sofwerx/polytope_node/GPS Shield/GPS Shield.jpg

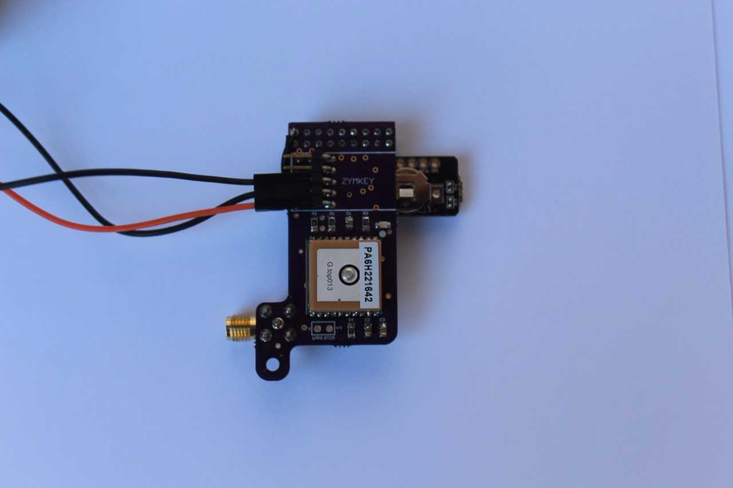
GPS Shield/GPS Shield.jpg
