sofwerx/polytope_node/GPS Shield/GPS Shield_Zymbit.jpg

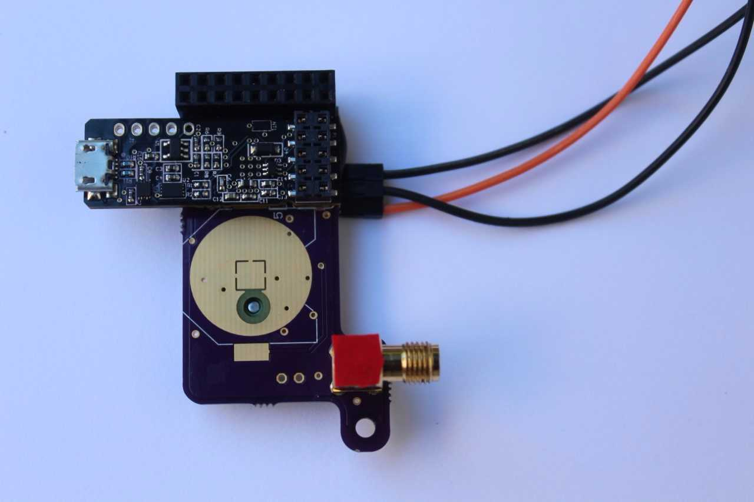
GPS Shield/GPS Shield_Zymbit.jpg
