sofwerx/polytope_node/README.md

# polytope_node
Compute/Sensor node for Polytope
