sofwerx/polytope_node/GPS Shield/GPS_Shield_BoardLayout.jpg

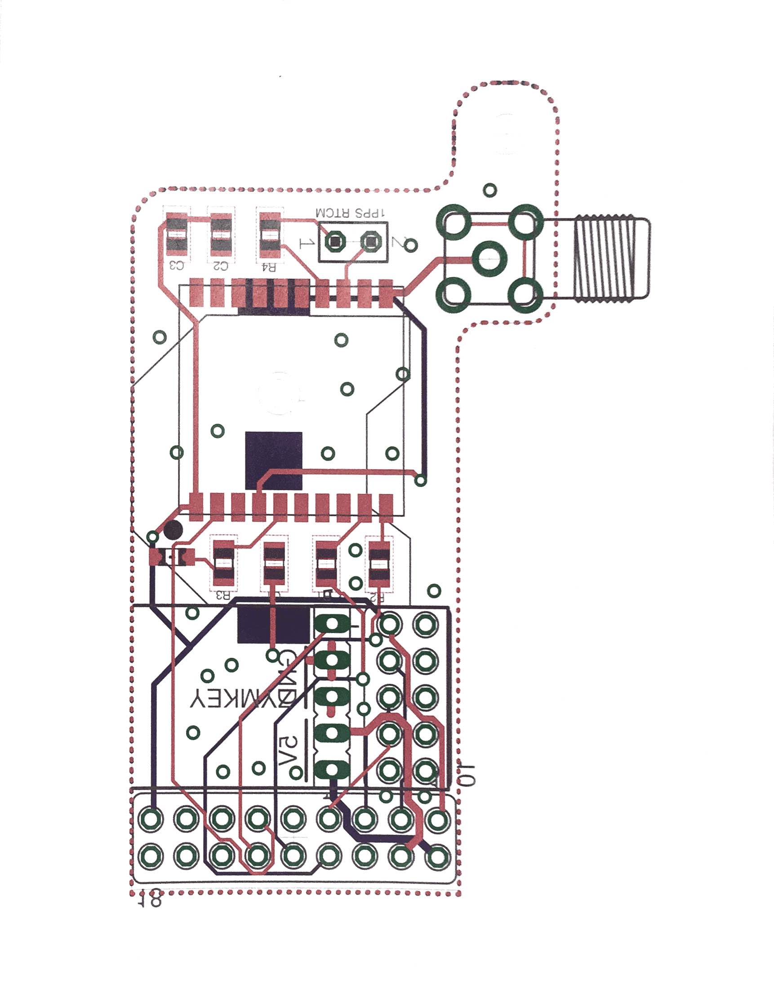
GPS Shield/GPS_Shield_BoardLayout.jpg
