sofwerx/polytope_node/GPS Shield/GPS_Shield_Schematic.jpg

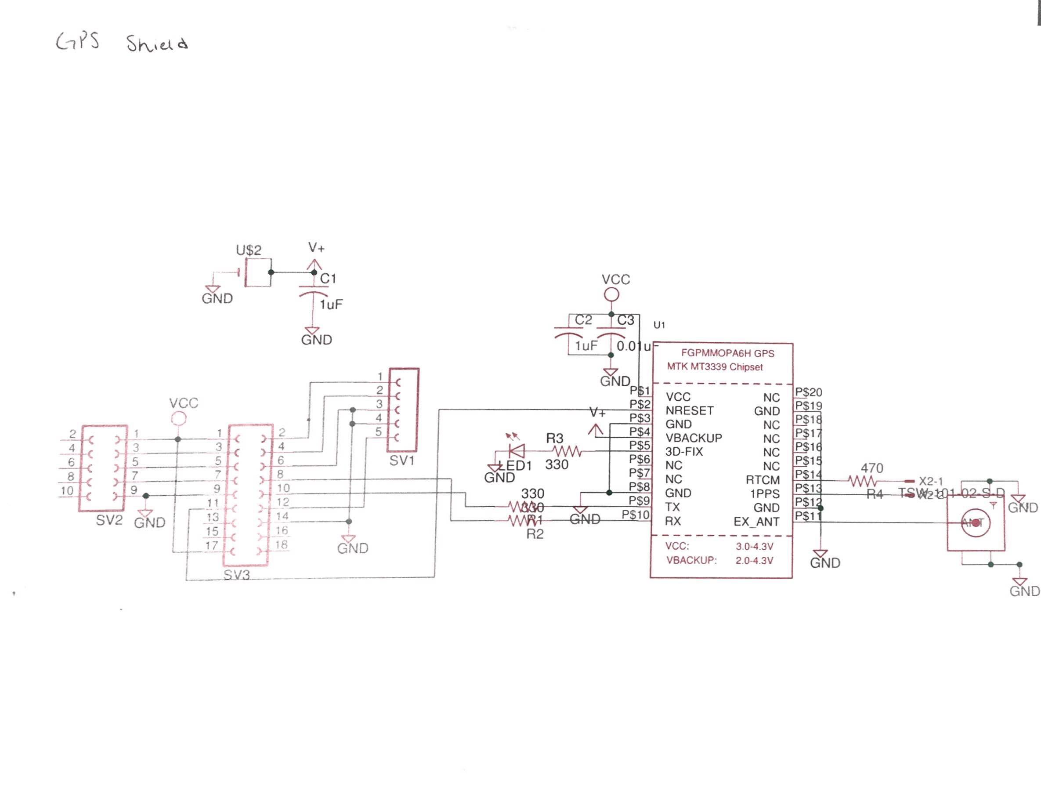
GPS Shield/GPS_Shield_Schematic.jpg
