sofwerx/polytope_node/Power Board/SDR-RPI 3.0/Power Board.jpg

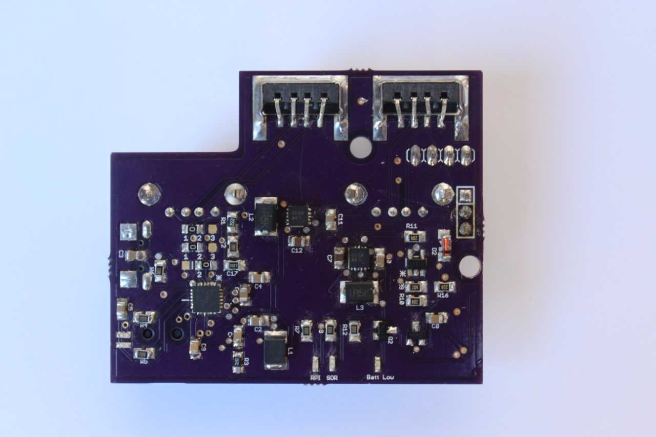
Power Board/SDR-RPI 3.0/Power Board.jpg
