sofwerx/polytope_node/GPS Shield/GPS_Shield_BOM.jpg

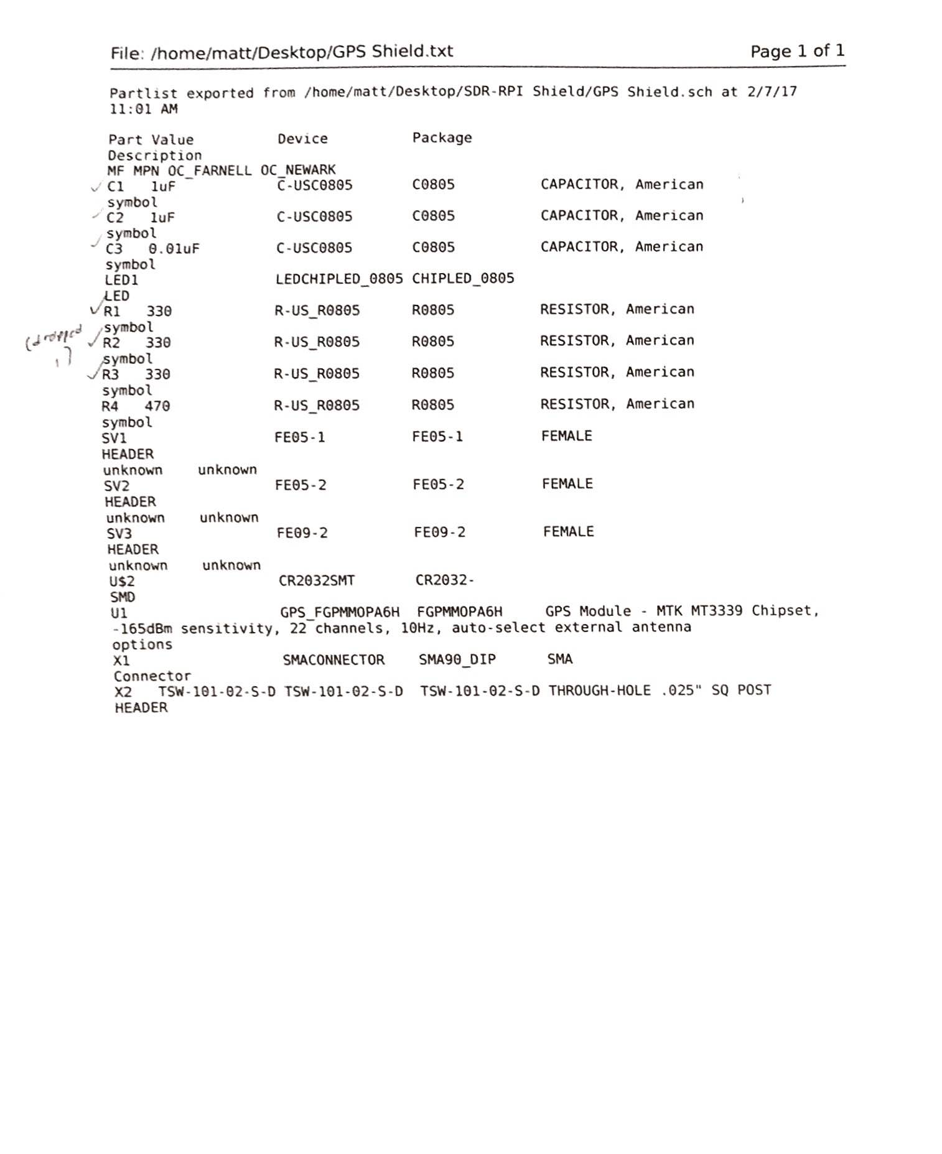
GPS Shield/GPS_Shield_BOM.jpg
