sofwerx/polytope_node/RFnode Enclosure/stl/SWXpiSDR2_body1.stl

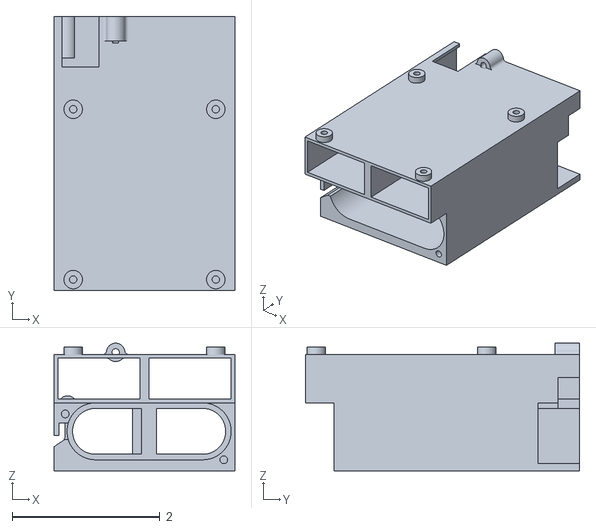
[picture p7: CAD file, 2017-07-17]
RFnode Enclosure/stl/SWXpiSDR2_body1.stl
2.44 x 3.71 x 1.73
