sofwerx/polytope_node/RFnode Enclosure/stl/SWXpiSDR2_body1_boardcap.stl

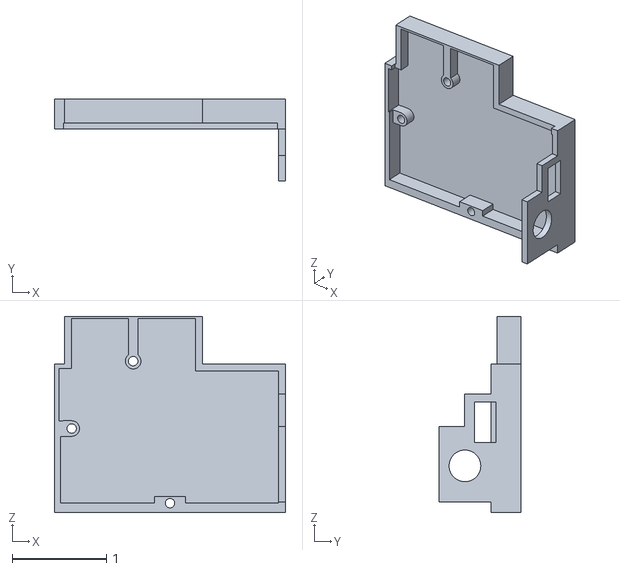
[picture p8: CAD file, 2017-07-17]
RFnode Enclosure/stl/SWXpiSDR2_body1_boardcap.stl
2.44 x 0.867 x 2.08
