sofwerx/polytope_node/RFnode Enclosure/stl/SWXpiSDR2_body1_top.stl

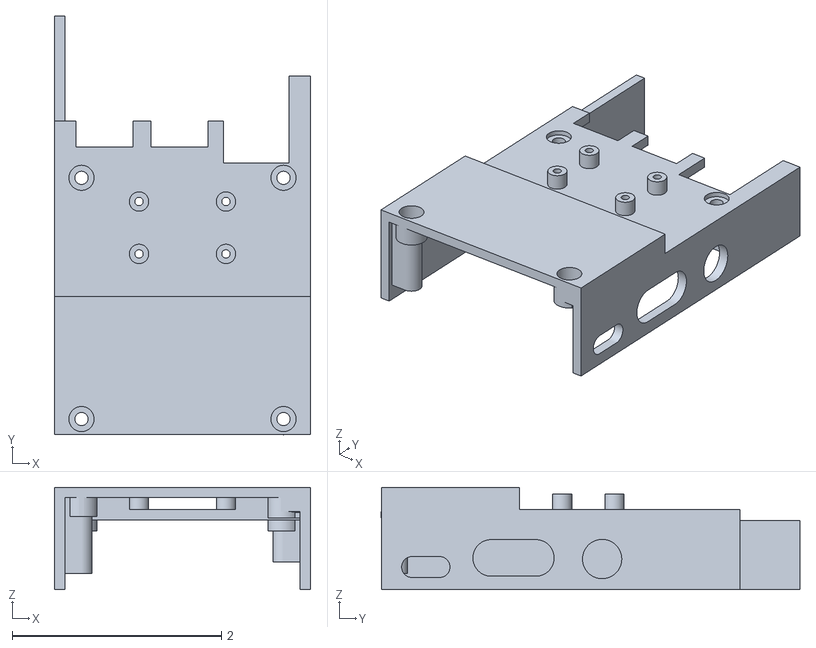
[picture p9: CAD file, 2017-07-17]
RFnode Enclosure/stl/SWXpiSDR2_body1_top.stl
2.44 x 4.00 x 0.979
