sofwerx/polytope_node/RFnode Enclosure/stl/SWXpiSDR2_body1_cap.stl

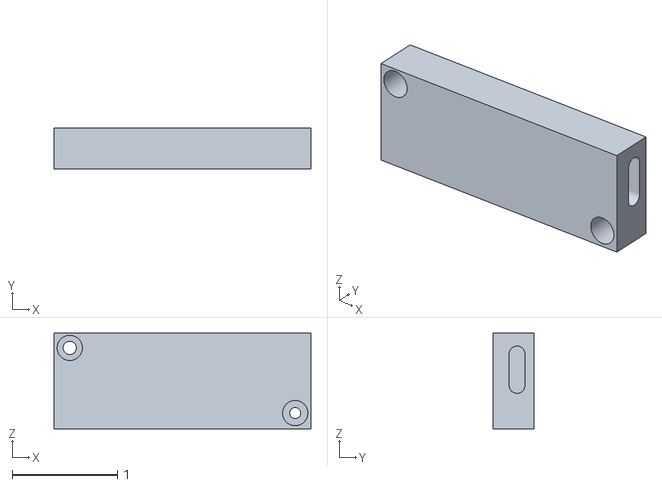
[picture p10: CAD file, 2017-07-17]
RFnode Enclosure/stl/SWXpiSDR2_body1_cap.stl
2.44 x 0.387 x 0.91
