sofwerx/polytope_node/(list of files, cad)

Other CAD files:
Fan Control/Microfan Controller.X/dist/default/production/Microfan_Controller.X.production.obj
