sofwerx/polytope_node/Fan Control/Microfan Controller.brd

## EAGLE design Fan Control/Microfan Controller.brd (2017-07-18)

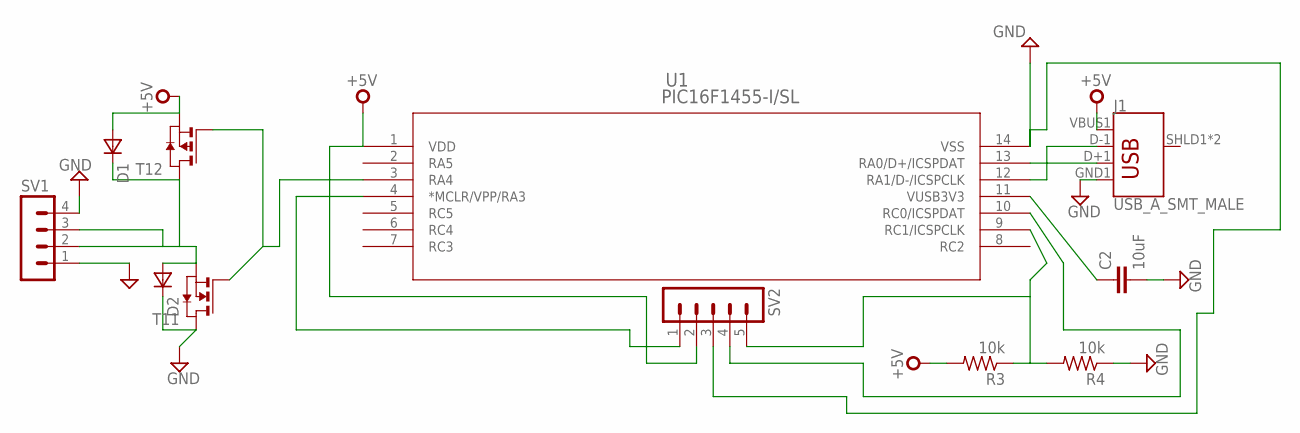
[picture p11: schematic Microfan Controller.sch]

Parts:
C2: 10uF; C0805
D1, D2: VAR2SOT23; SOT-23
J1: USB_A_SMT_MALE; USB-A-SMT-MALE
R3, R4: 10k; R0805
SV1: MA04-1
SV2: MA05-1
T1: PN_MOSFET-MSOP8; MSOP8
U1: PIC16F1455-I/SL; SOIC14_SL

Connections:
+5V: D1.3 (A), J1.VBUS1 (VBUS), R3.2, SV2.2, T1.3 (S), U1.1 (VDD)
GND: C2.2, D2.1 (C), J1.GND1 (GND), R4.1, SV1.1, SV1.4, T1.7 (D), T1.8 (D)
unnamed: SV2.1, U1.4 (*MCLR/VPP/RA3)
unnamed: J1.D-1 (D-), U1.12 (RA1/D-/ICSPCLK)
unnamed: T1.2 (G), T1.4 (G), U1.3 (RA4)
unnamed: R3.1, R4.2, SV2.5, U1.9 (RC1/ICSPCLK)
unnamed: D1.1 (C), D2.3 (A), SV1.2, SV1.3, T1.1 (S), T1.5 (D), T1.6 (D)
unnamed: J1.D+1 (D+), U1.13 (RA0/D+/ICSPDAT)
unnamed: SV2.3, U1.14 (VSS)
unnamed: SV2.4, U1.10 (RC0/ICSPDAT)
VUSB3V3: U1.11 (VUSB3V3)

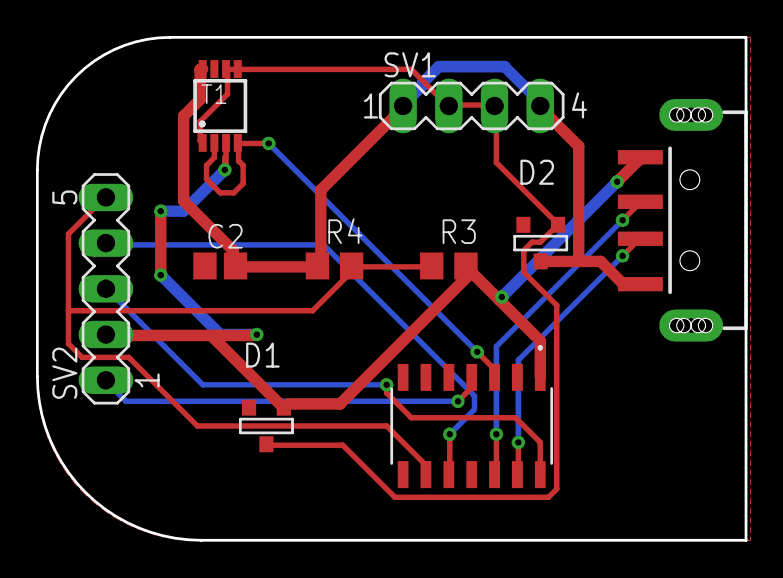
[picture p12: board Microfan Controller.brd from above]

Board: 2 copper layers, 39.4 x 27.9 mm, 10 parts (0 on the bottom side), 10 nets.
