sofwerx/polytope_node/Power Board/SDR-RPI 3.0/SDR-RPI Shield 3.0.brd

## EAGLE design Power Board/SDR-RPI 3.0/SDR-RPI Shield 3.0.brd (2017-07-06)

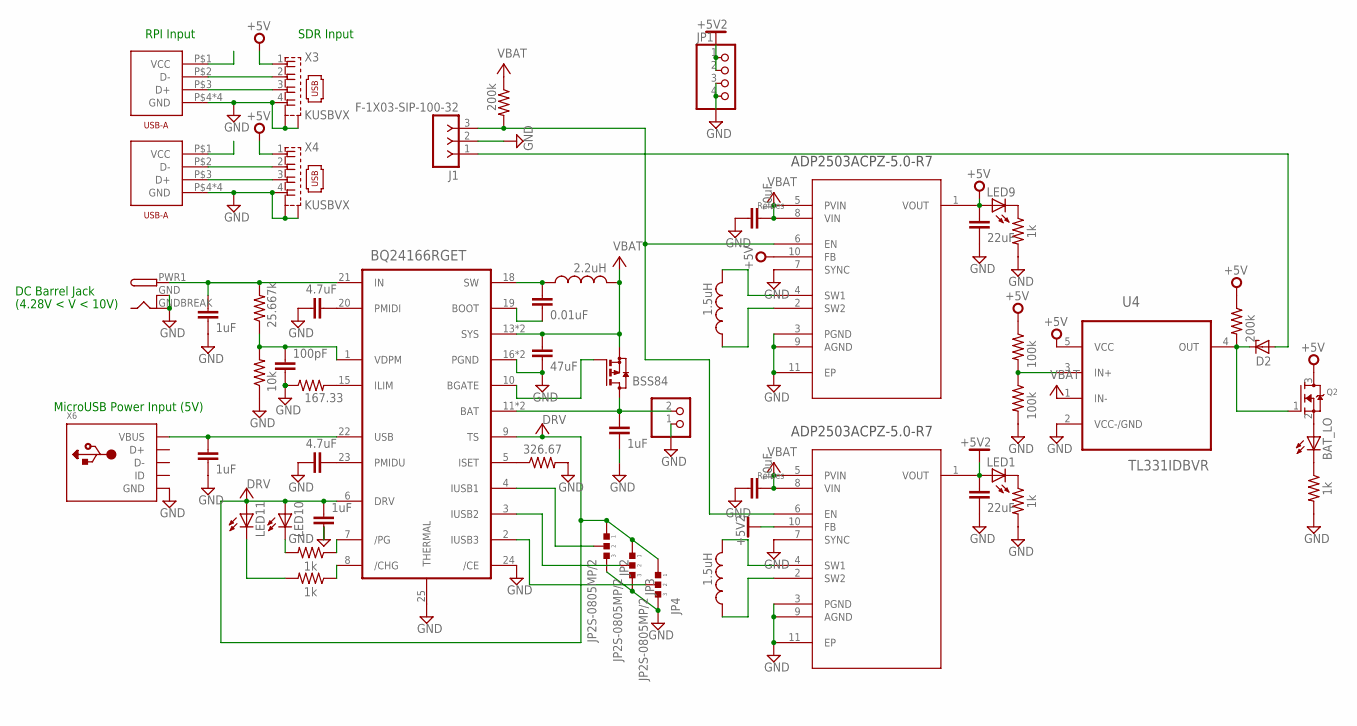
[picture p13: schematic SDR-RPI Shield 3.0.sch]

Parts:
BAT_LO: LED_ESML0603; LED_SML0603
C1, C3, C5, C8: 1uF; C0805
C2, C4: 4.7uF; C0805
C6: 0.01uF; C0805
C7, C12: 22uF; C0805
C9: 47uF; C0805
C10, C11: 10uF; C0805
C17: 100pF; C0805
CN1: JST_2PIN-SMT; JST-PH-2-SMT
CN3: DCBARRELSMT; DCJACK_2MM_SMT
D2: ZENER-DIODESOD80C; SOD80C
J1: F-1X03-SIP-100-32; SIP-100-03-32
JP1: PINHD-1X4; 1X04
JP2, JP3, JP4: JP2S-0805MP/2; R0805MP/2
L1: 2.2uH; L1812
L2, L3: 1.5uH; L1812
LED1, LED9, LED10, LED11: LED_ESML0603; LED_SML0603
Q1: BSS84; SOT23
Q2: MOSFET-NREFLOW; SOT23
R1: 25.667k; M0805
R2: 10k; M0805
R3: 167.33; M0805
R4, R5, R7, R8, R12: 1k; M0805
R6: 326.67; M0805
R9, R10: 100k; M0805
R11, R16: 200k; M0805
U1: BQ24166RGET; QFN50P400X400X100-25N
U2, U3: ADP2503ACPZ-5.0-R7; DFN300X300X80-11N
U4: TL331IDBVR; SOT95P280X145-5N
U$1, U$2: USB-A
X3, X4: KUSBVX
X6: USB_MICRO_20329_V2; 4UCONN_20329_V2

Connections:
+5V: C12.1, LED9.A, Q2.3 (D), R9.1, R11.1, U3.1 (VOUT), U3.10 (FB), U4.5 (VCC), X3.1, X4.1
+5V2: C7.1, JP1.1, JP1.2, LED1.A, U2.1 (VOUT), U2.10 (FB)
DRV: C5.1, JP2.1, JP3.1, JP4.1, LED10.A, LED11.A, U1.6 (DRV), U1.9 (TS)
GND: C1.2, C2.2, C3.2, C4.2, C5.2, C7.2, C8.2, C9.2, C10.1, C11.1, C12.2, C17.2, CN1.1 (2), CN3.GND (GNDBREAK), CN3.GNDBREAK (GND), J1.2, JP1.3, JP1.4, JP2.3, JP3.3, JP4.3, R2.1, R3.1, R6.2, R7.2, R8.2, R10.2, R12.2, U1.16 (PGND), U1.17 (PGND), U1.24 (/CE), U1.25 (THERMAL), U2.3 (PGND), U2.7 (SYNC), U2.9 (AGND), U2.11 (EP), U3.3 (PGND), U3.7 (SYNC), U3.9 (AGND), U3.11 (EP), U4.2 (VCC-/GND), U$1.P$4 (GND), U$1.P$5 (GND), U$1.P$6 (GND), U$1.P$8 (GND), U$2.P$4 (GND), U$2.P$5 (GND), U$2.P$6 (GND), U$2.P$8 (GND), X3.4, X3.M1 (S1), X3.M2 (S2), X4.4, X4.M1 (S1), X4.M2 (S2), X6.BASE@1 (GND), X6.BASE@2 (GND), X6.GND, X6.SPRT@1 (GND), X6.SPRT@2 (GND), X6.SPRT@3 (GND), X6.SPRT@4 (GND)
unnamed: C17.1, R1.1, R2.2, U1.1 (VDPM)
unnamed: R4.1, U1.7 (/PG)
unnamed: R5.1, U1.8 (/CHG)
unnamed: C1.1, CN3.PWR1 (PWR), R1.2, U1.21 (IN)
unnamed: C2.1, U1.20 (PMIDI)
unnamed: R3.2, U1.15 (ILIM)
unnamed: C3.1, U1.22 (USB), X6.VBUS
unnamed: C4.1, U1.23 (PMIDU)
unnamed: Q1.1 (G), U1.10 (BGATE)
unnamed: LED10.C, R4.2
unnamed: C6.2, U1.19 (BOOT)
unnamed: LED11.C, R5.2
unnamed: C6.1, L1.1, U1.18 (SW)
unnamed: J1.3, R16.2, U2.6 (EN), U3.6 (EN)
unnamed: L2.2, U3.4 (SW1)
unnamed: L2.1, U3.2 (SW2)
unnamed: C8.1, CN1.2 (1), Q1.3 (D), U1.11 (BAT), U1.12 (BAT)
unnamed: R6.1, U1.5 (ISET)
unnamed: R9.2, R10.1, U4.3 (IN+)
unnamed: LED1.C, R7.1
unnamed: L3.2, U2.4 (SW1)
unnamed: LED9.C, R8.1
unnamed: D2.A, J1.1
unnamed: L3.1, U2.2 (SW2)
unnamed: BAT_LO.A, Q2.2 (S)
unnamed: D2.C, Q2.1 (G), R11.2, U4.4 (OUT)
unnamed: BAT_LO.C, R12.1
unnamed: U$1.P$2 (D-), X3.2
unnamed: U$1.P$3 (D+), X3.3
unnamed: U$2.P$2 (D-), X4.2
unnamed: U$2.P$3 (D+), X4.3
unnamed: JP2.2, U1.4 (IUSB1)
unnamed: JP3.2, U1.3 (IUSB2)
unnamed: JP4.2, U1.2 (IUSB3)
V+: C9.1, C10.2, C11.2, L1.2, Q1.2 (S), R16.1, U1.13 (SYS), U1.14 (SYS), U2.5 (PVIN), U2.8 (VIN), U3.5 (PVIN), U3.8 (VIN), U4.1 (IN-)

Notes on the sheet:
RPI Input
SDR Input
MicroUSB Power Input (5V)
DC Barrel Jack
(4.28V < V < 10V)

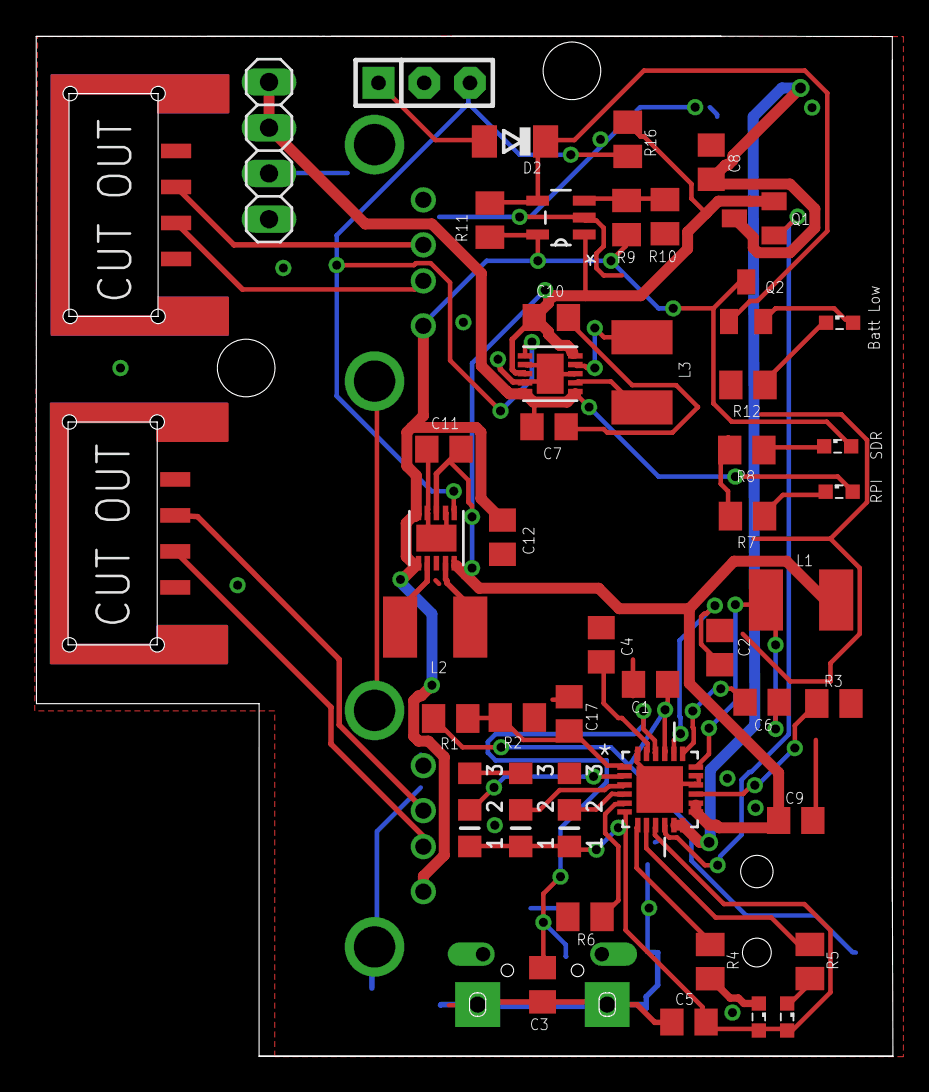
[picture p14: board SDR-RPI Shield 3.0.brd from above]

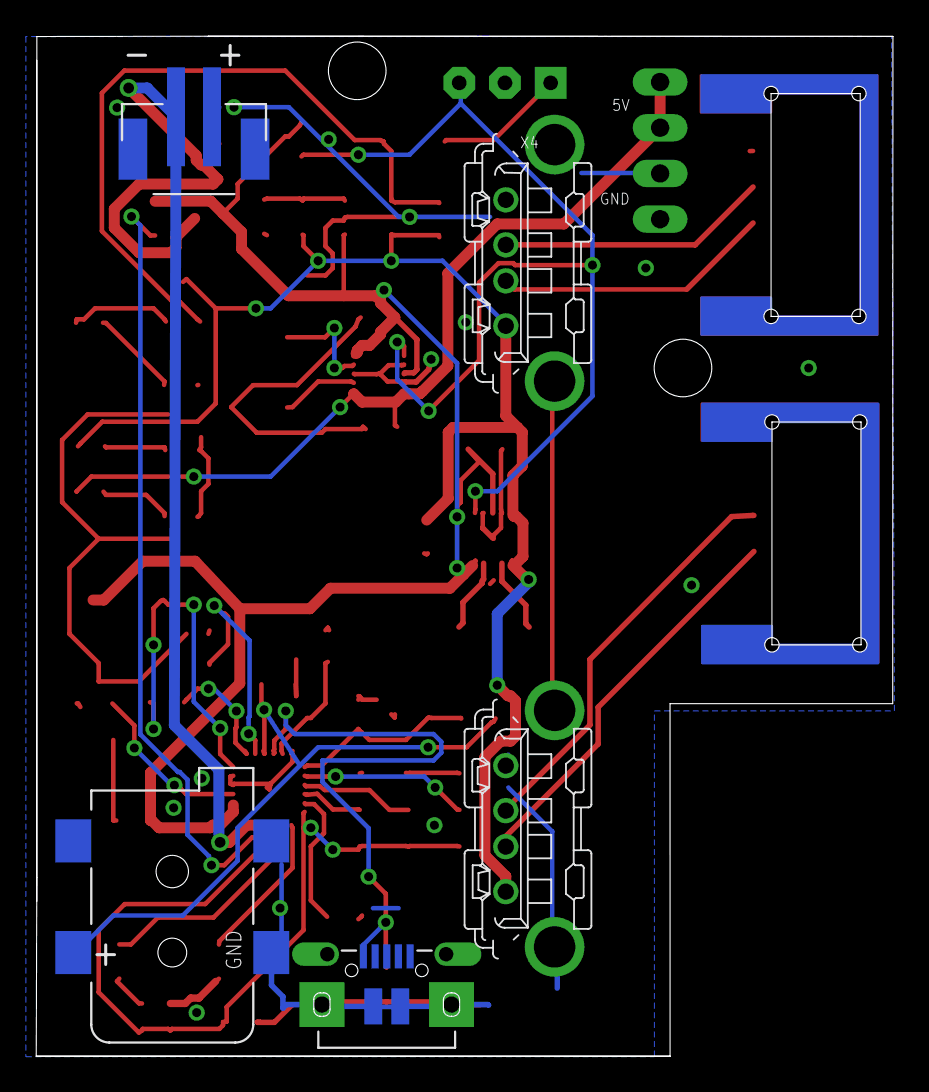
[picture p15: board SDR-RPI Shield 3.0.brd from below]

Board: 2 copper layers, 47.6 x 56.7 mm, 53 parts (5 on the bottom side), 39 nets.
