sofwerx/polytope_node/Fan Control/Microfan Controller.X/mcc_generated_files/pin_manager.h

#ifndef PIN_MANAGER_H
#define PIN_MANAGER_H

#define INPUT   1
#define OUTPUT  0

#define HIGH    1
#define LOW     0

#define ANALOG      1
#define DIGITAL     0

#define PULL_UP_ENABLED      1
#define PULL_UP_DISABLED     0

#define IO_RA0_PORT               PORTAbits.RA0
#define IO_RA0_GetValue()           PORTAbits.RA0

#define IO_RA1_PORT               PORTAbits.RA1
#define IO_RA1_GetValue()           PORTAbits.RA1

#define IO_RA4_TRIS               TRISAbits.TRISA4
#define IO_RA4_LAT                LATAbits.LATA4
#define IO_RA4_PORT               PORTAbits.RA4
#define IO_RA4_WPU                WPUAbits.WPUA4
#define IO_RA4_ANS                ANSELAbits.ANSA4
#define IO_RA4_SetHigh()            do { LATAbits.LATA4 = 1; } while(0)
#define IO_RA4_SetLow()             do { LATAbits.LATA4 = 0; } while(0)
#define IO_RA4_Toggle()             do { LATAbits.LATA4 = ~LATAbits.LATA4; } while(0)
#define IO_RA4_GetValue()           PORTAbits.RA4
#define IO_RA4_SetDigitalInput()    do { TRISAbits.TRISA4 = 1; } while(0)
#define IO_RA4_SetDigitalOutput()   do { TRISAbits.TRISA4 = 0; } while(0)
#define IO_RA4_SetPullup()      do { WPUAbits.WPUA4 = 1; } while(0)
#define IO_RA4_ResetPullup()    do { WPUAbits.WPUA4 = 0; } while(0)
#define IO_RA4_SetAnalogMode()  do { ANSELAbits.ANSA4 = 1; } while(0)
#define IO_RA4_SetDigitalMode() do { ANSELAbits.ANSA4 = 0; } while(0)

#define IO_RC0_TRIS               TRISCbits.TRISC0
#define IO_RC0_LAT                LATCbits.LATC0
#define IO_RC0_PORT               PORTCbits.RC0
#define IO_RC0_ANS                ANSELCbits.ANSC0
#define IO_RC0_SetHigh()            do { LATCbits.LATC0 = 1; } while(0)
#define IO_RC0_SetLow()             do { LATCbits.LATC0 = 0; } while(0)
#define IO_RC0_Toggle()             do { LATCbits.LATC0 = ~LATCbits.LATC0; } while(0)
#define IO_RC0_GetValue()           PORTCbits.RC0
#define IO_RC0_SetDigitalInput()    do { TRISCbits.TRISC0 = 1; } while(0)
#define IO_RC0_SetDigitalOutput()   do { TRISCbits.TRISC0 = 0; } while(0)
#define IO_RC0_SetAnalogMode()  do { ANSELCbits.ANSC0 = 1; } while(0)
#define IO_RC0_SetDigitalMode() do { ANSELCbits.ANSC0 = 0; } while(0)

#define IO_RC1_TRIS               TRISCbits.TRISC1
#define IO_RC1_LAT                LATCbits.LATC1
#define IO_RC1_PORT               PORTCbits.RC1
#define IO_RC1_ANS                ANSELCbits.ANSC1
#define IO_RC1_SetHigh()            do { LATCbits.LATC1 = 1; } while(0)
#define IO_RC1_SetLow()             do { LATCbits.LATC1 = 0; } while(0)
#define IO_RC1_Toggle()             do { LATCbits.LATC1 = ~LATCbits.LATC1; } while(0)
#define IO_RC1_GetValue()           PORTCbits.RC1
#define IO_RC1_SetDigitalInput()    do { TRISCbits.TRISC1 = 1; } while(0)
#define IO_RC1_SetDigitalOutput()   do { TRISCbits.TRISC1 = 0; } while(0)
#define IO_RC1_SetAnalogMode()  do { ANSELCbits.ANSC1 = 1; } while(0)
#define IO_RC1_SetDigitalMode() do { ANSELCbits.ANSC1 = 0; } while(0)

void PIN_MANAGER_Initialize (void);
void PIN_MANAGER_IOC(void);



#endif
