sofwerx/polytope_node/(notices)

Notices in the files:
parts and their libraries:
con-headers-jp: Copyright (C) 2008, Bob Starr
jumpers: Copyright (C) 2009, Bob Starr
supply0: Copyright (C) 2007, Bob Starr
SparkFun-Connectors: Licensing: Creative Commons ShareAlike 4.0 International - https://creativecommons.org/licenses/by-sa/4.0
